ScaleXY/ESPS3Dongle/hardware/kicad/out/top.png

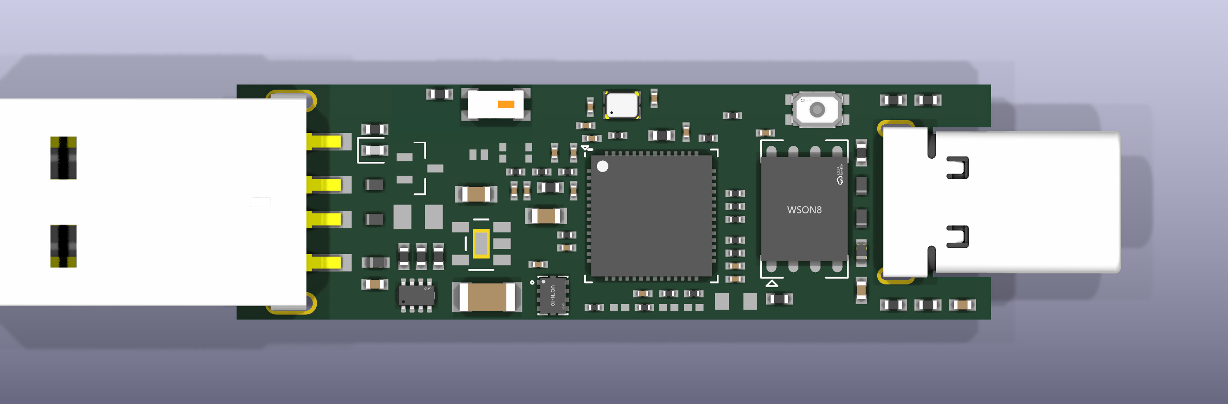
hardware/kicad/out/top.png
