ScaleXY/ESPS3Dongle/hardware/kicad/out/bottom.png

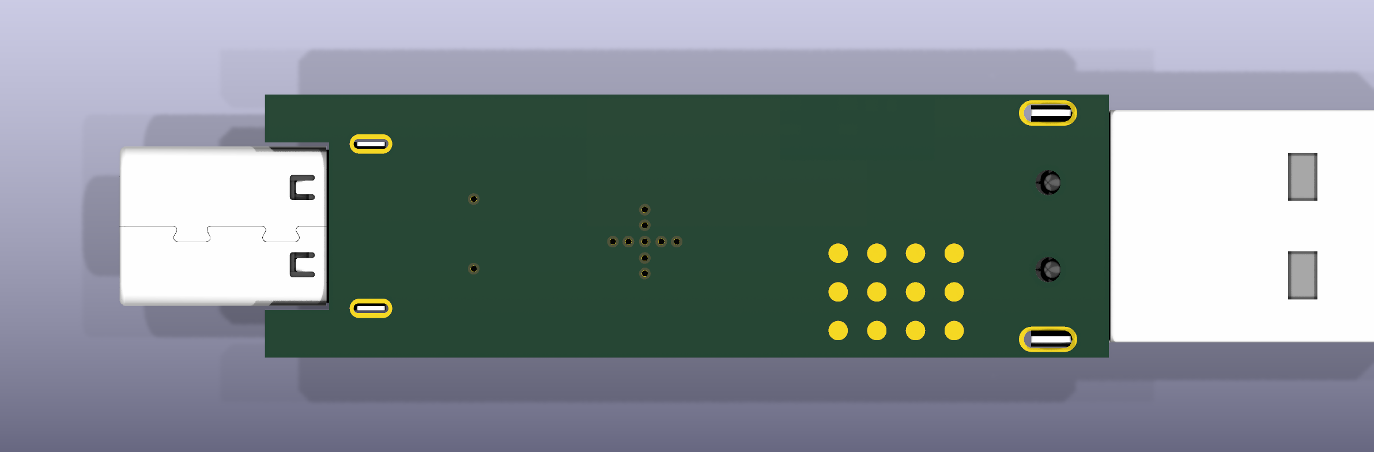
hardware/kicad/out/bottom.png
