ScaleXY/ESPS3Dongle/hardware/kicad/out/iso.png

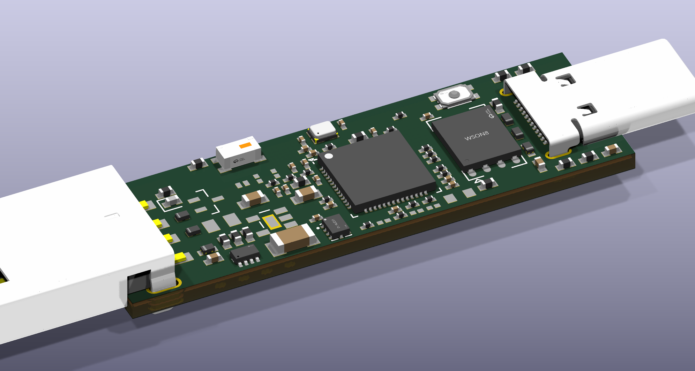
hardware/kicad/out/iso.png
