ScaleXY/ESPS3Dongle/hardware/kicad/out/schematic.pdf

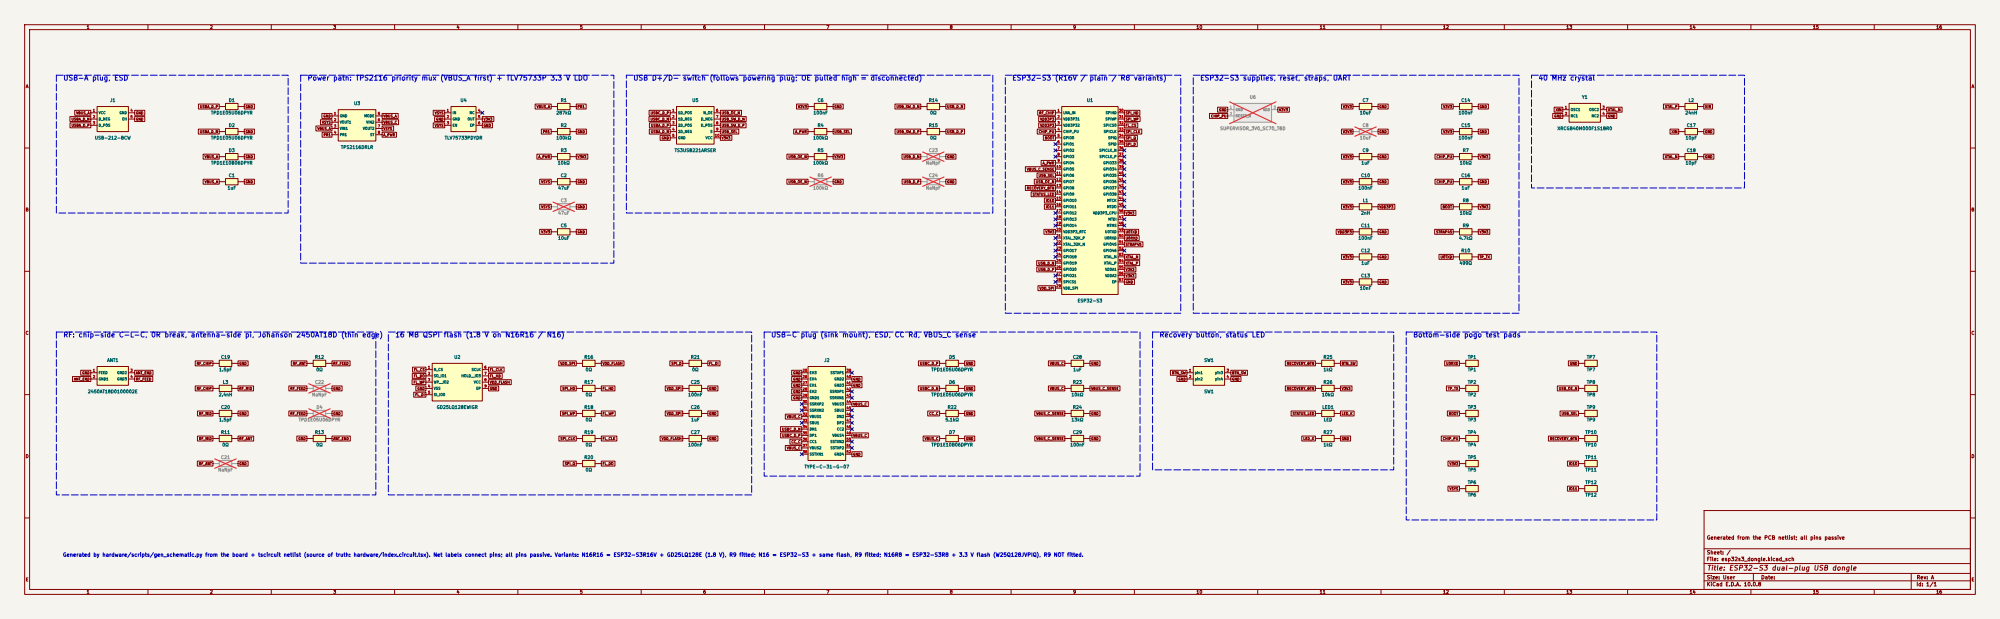
[picture p4: page 1]

USB D+/D- switch (follows powering plug; OE pulled high = disconnected)

ESP32-S3 supplies, reset, straps, UART

RF: chip-side C-L-C, 0R break, antenna-side pi, Johanson 2450AT18D (thin edge)

16 MB QSPI flash (1.8 V on N16R16 / N16)

Bottom-side pogo test pads

Generated from the PCB netlist; all pins passive

Generated by hardware/scripts/gen_schematic.py from the board + tscircuit netlist (source of truth: hardware/index.circuit.tsx). Net labels connect pins; all pins passive. Variants: N16R16 = ESP32-S3R16V + GD25LQ128E (1.8 V), R9 fitted; N16 = ESP32-S3 + same flash, R9 fitted; N16R8 = ESP32-S3R8 + 3.3 V flash (W25Q128JVPIQ), R9 NOT fitted.

Sheet: /
File: esp32s3_dongle.kicad_sch
Title: ESP32-S3 dual-plug USB dongle

Size: User | Rev: A
