ScaleXY/ESPS3Dongle/hardware/kicad/esp32s3_dongle.kicad_pcb

## KiCad design hardware/kicad/esp32s3_dongle.kicad_pcb (2026-11-11)

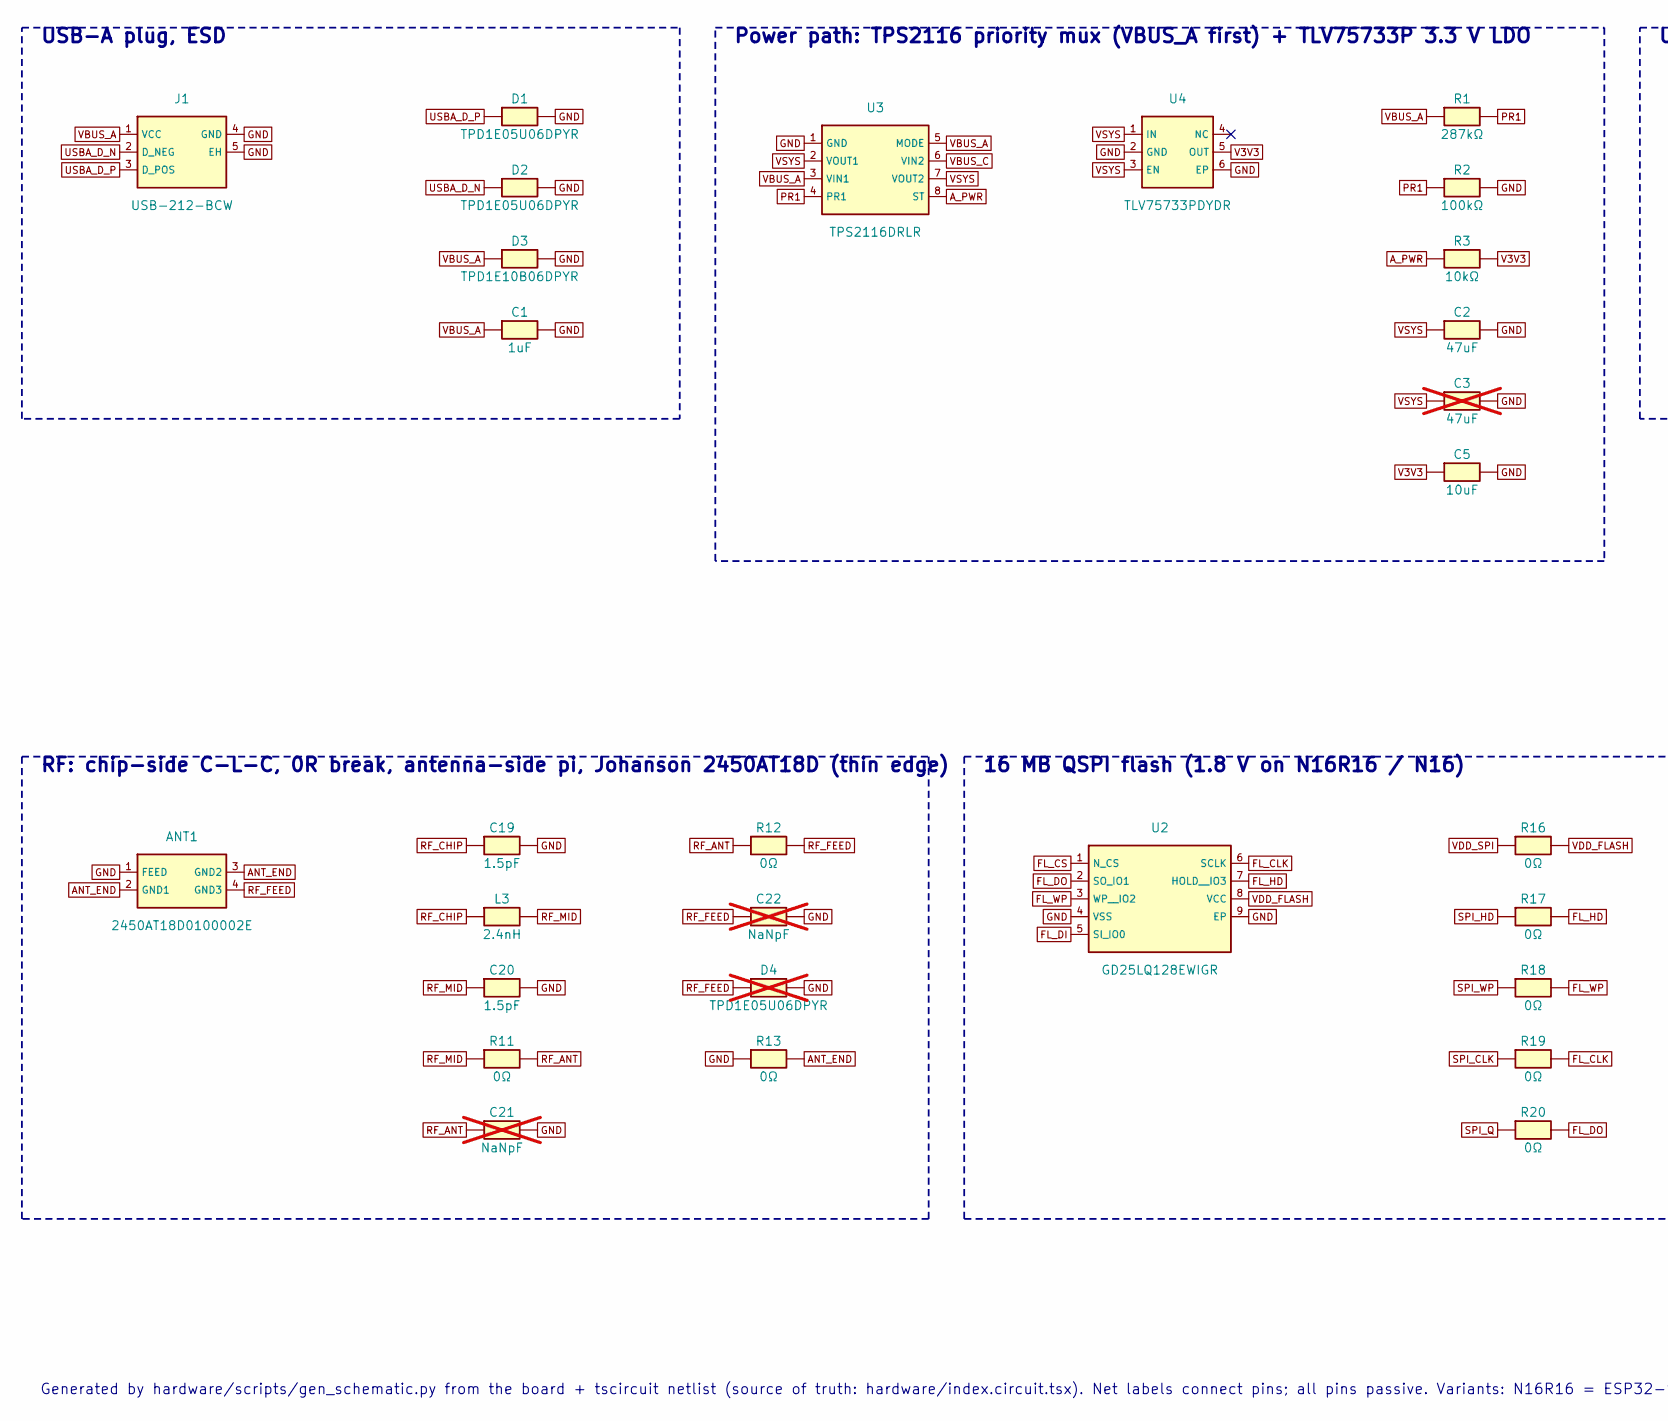
[picture p5: schematic esp32s3_dongle.kicad_sch, ESP32-S3 dual-plug USB dongle, part in row 1, column 1]

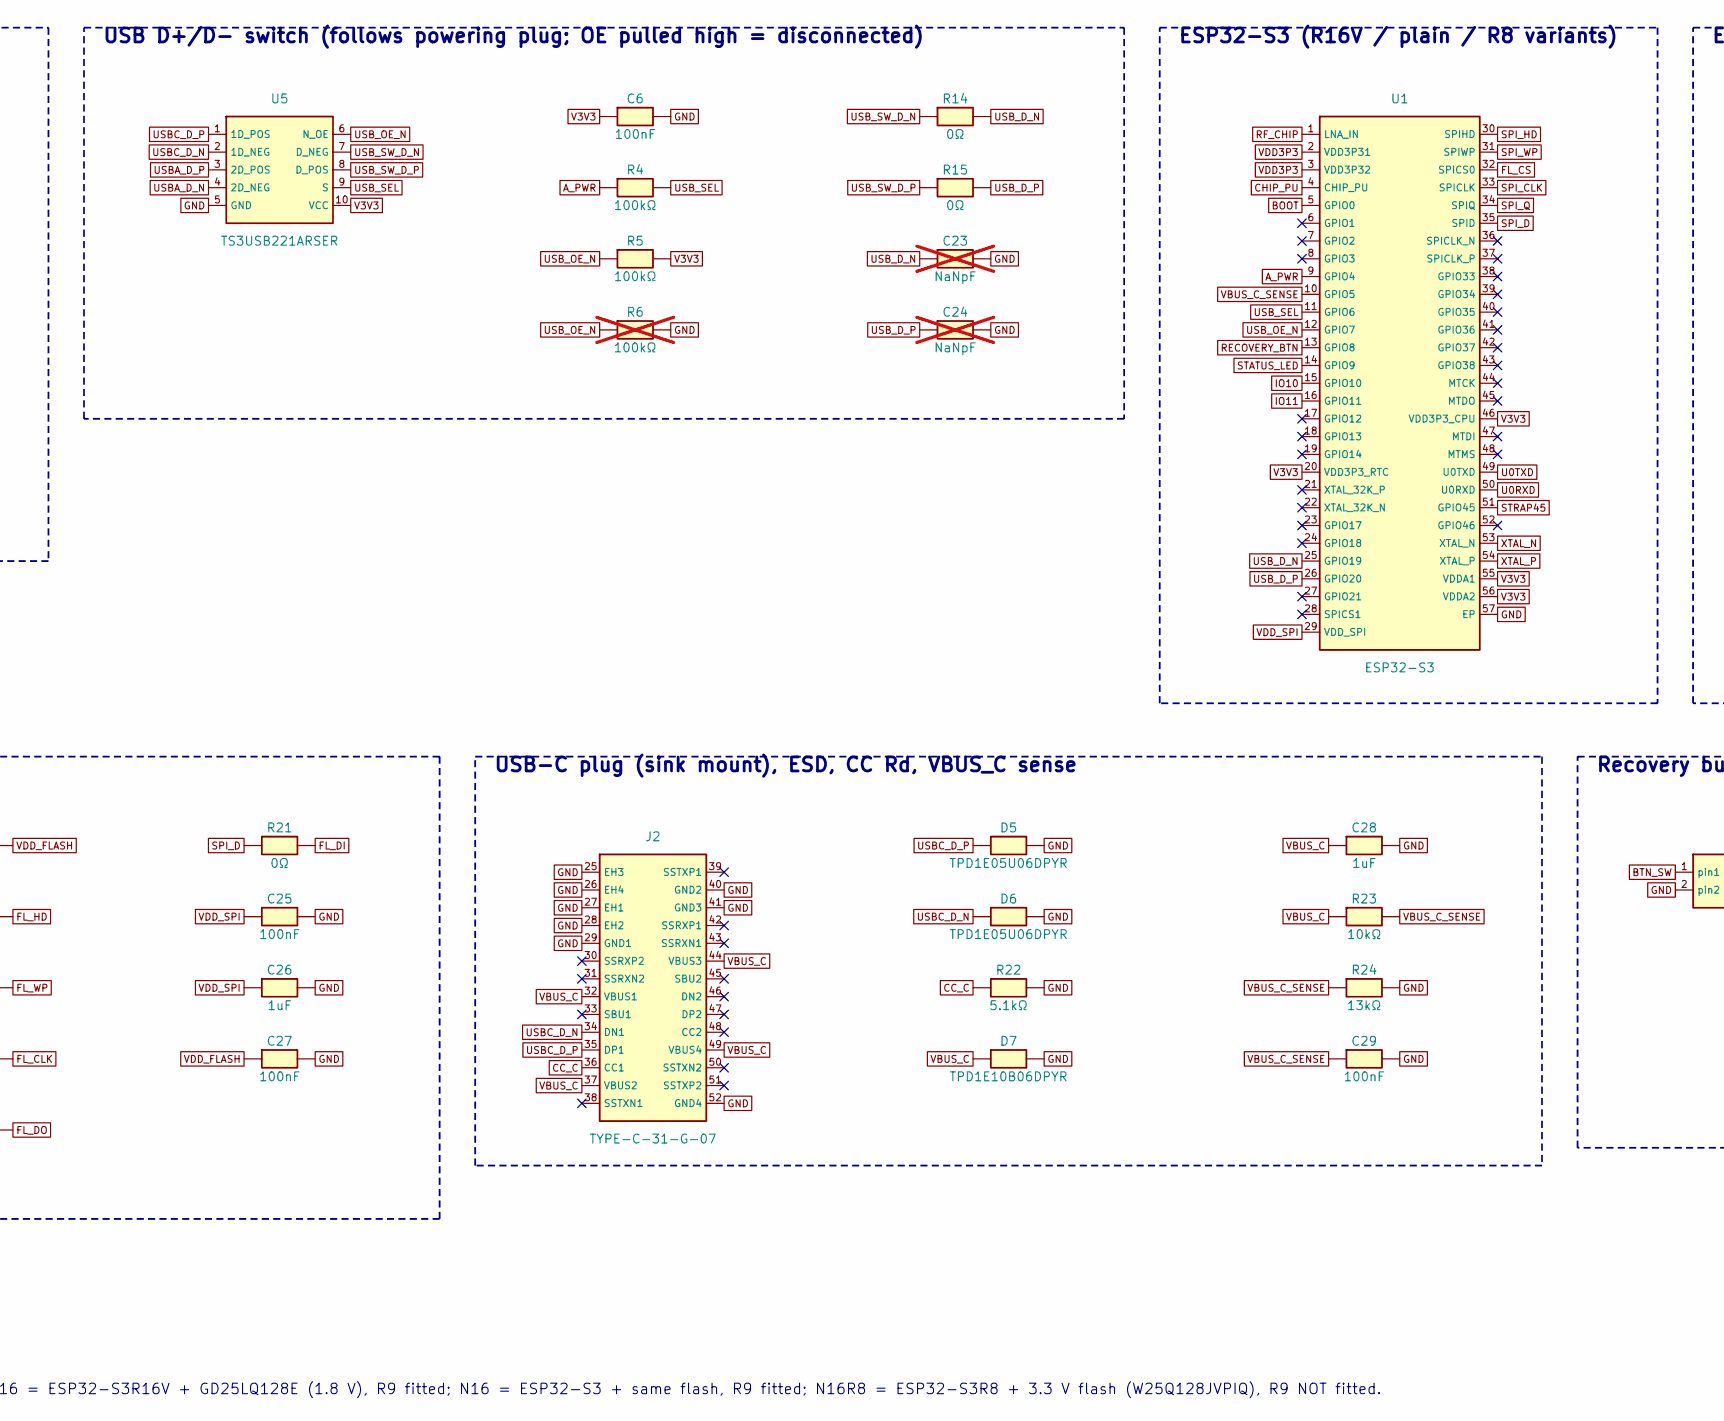
[picture p6: schematic esp32s3_dongle.kicad_sch, ESP32-S3 dual-plug USB dongle, part in row 1, column 2]

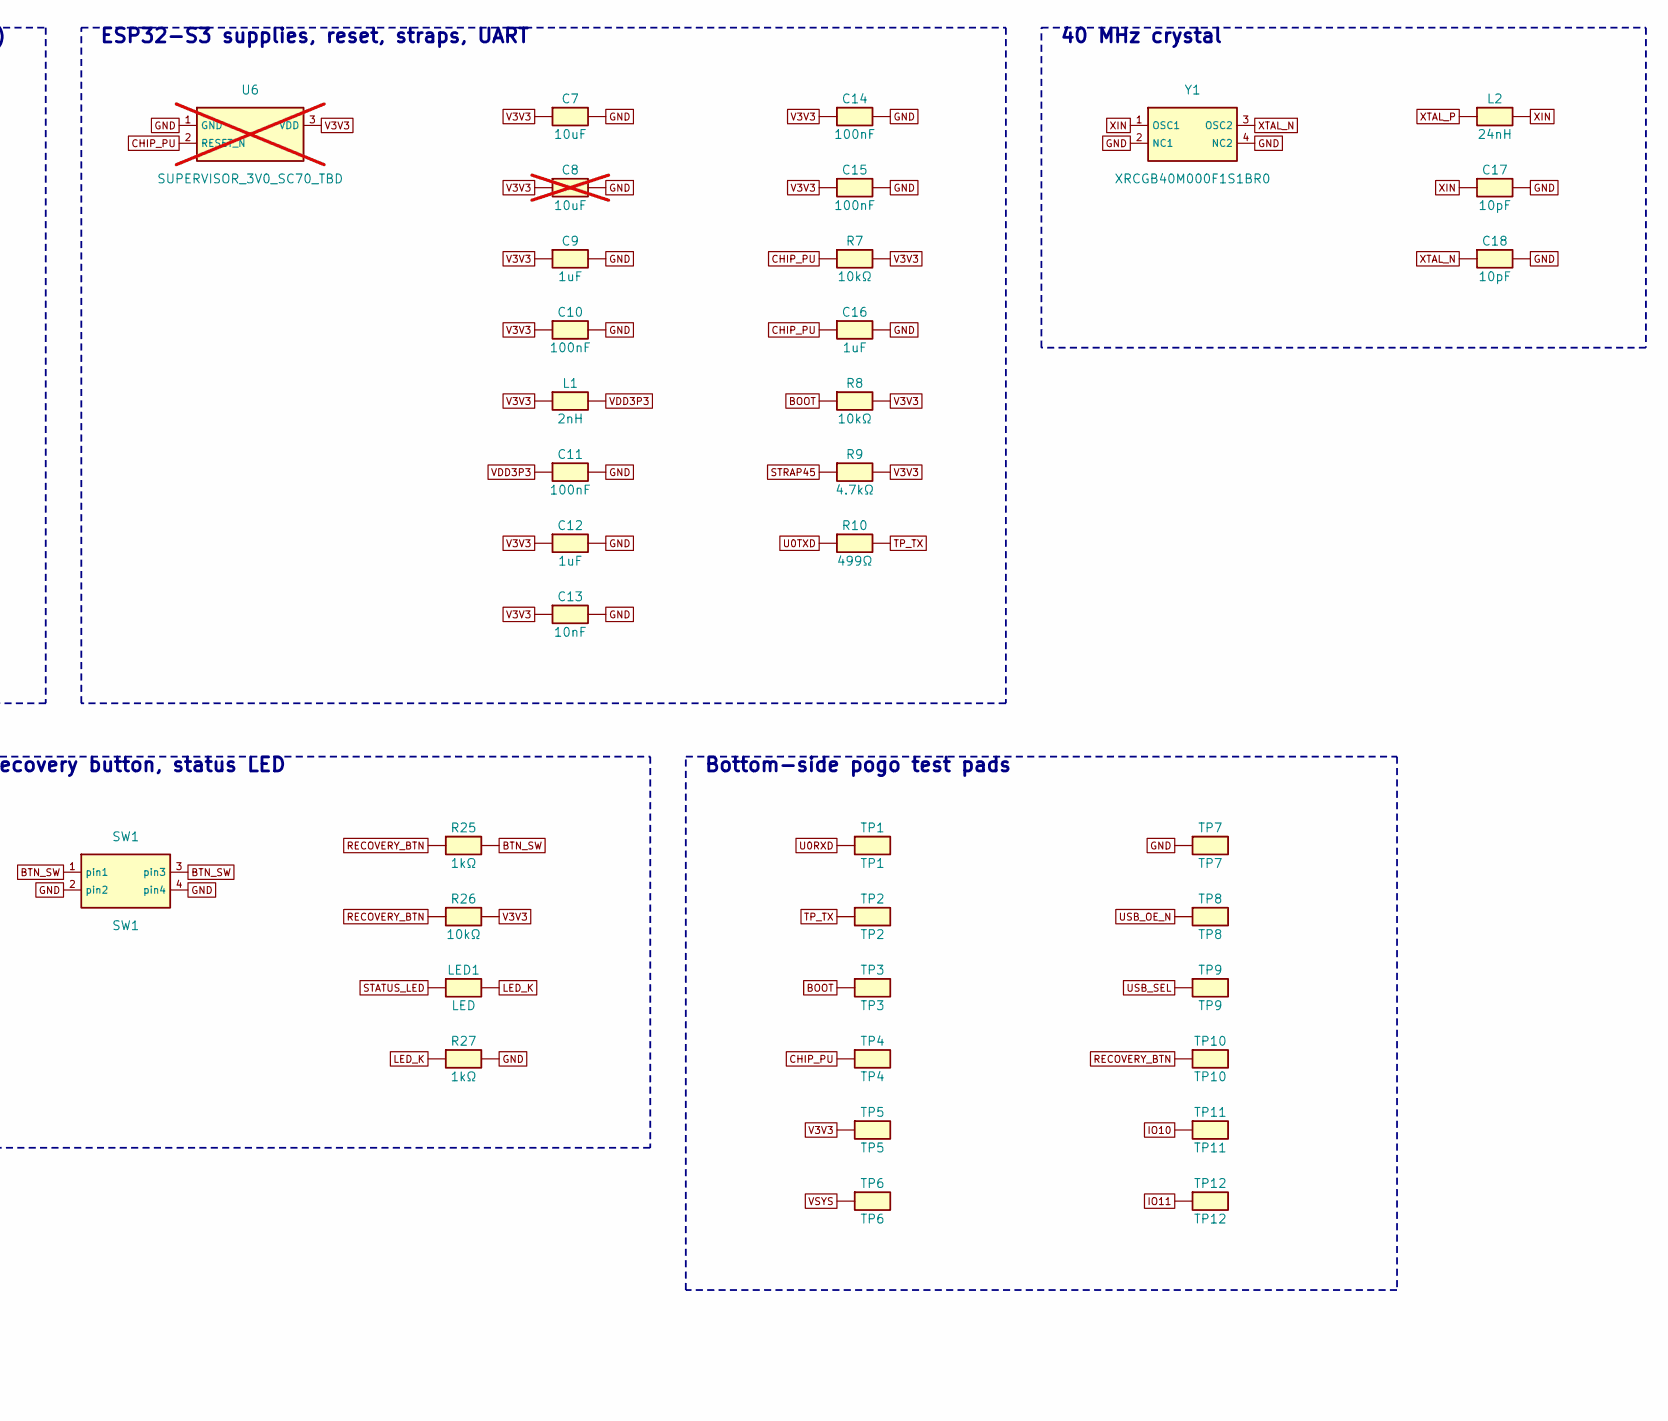
[picture p7: schematic esp32s3_dongle.kicad_sch, ESP32-S3 dual-plug USB dongle, part in row 1, column 3]

Parts:
ANT1: 2450AT18D0100002E; MPN 2450AT18D0100002E; LCSC C17410360
C1, C28: 1uF; capacitor_cap0402_nonpolarized
C2: 47uF; capacitor_cap1206_nonpolarized
C3: 47uF; capacitor; not fitted
C5, C7: 10uF; capacitor_cap0603_nonpolarized
C6, C10, C11, C14, C15, C25, C27: 100nF; capacitor_cap0201_nonpolarized
C8: 10uF; capacitor; not fitted
C9, C12, C16, C26: 1uF; capacitor_cap0201_nonpolarized
C13: 10nF; capacitor_cap0201_nonpolarized
C17, C18: 10pF; capacitor_cap0201_nonpolarized
C19, C20: 1.5pF; capacitor_cap0201_nonpolarized
C21, C22, C23, C24: NaNpF; capacitor; not fitted
C29: 100nF; capacitor_cap0402_nonpolarized
D1, D2, D5, D6: TPD1E05U06DPYR; MPN TPD1E05U06DPYR; LCSC C436349
D3, D7: TPD1E10B06DPYR; MPN TPD1E10B06DPYR; LCSC C48260
D4: TPD1E05U06DPYR; MPN TPD1E05U06DPYR; LCSC C436349; not fitted
J1: USB-212-BCW; MPN USB-212-BCW; LCSC C720521
J2: TYPE-C-31-G-07; MPN TYPE-C-31-G-07; LCSC C530607
L1: 2nH; inductor_0402
L2: 24nH; inductor_0201
L3: 2.4nH; inductor_0201
LED1: LED; led_diode0402_color_green
R1: 287kΩ; resistor_res0402
R2: 100kΩ; resistor_res0402
R3, R23, R26: 10kΩ; resistor_res0402
R4, R5: 100kΩ; resistor_res0201
R6: 100kΩ; resistor; not fitted
R7, R8: 10kΩ; resistor_res0201
R9: 4.7kΩ; resistor_res0402
R10: 499Ω; resistor_res0201
R11, R12, R14, R15, R17, R18, R19, R20, R21: 0Ω; resistor_res0201
R13, R16: 0Ω; resistor_res0402
R22: 5.1kΩ; resistor_res0402
R24: 13kΩ; resistor_res0402
R25, R27: 1kΩ; resistor_res0402
SW1: SW1; SKSVCAE010; MPN SKSVCAE010; LCSC C115364
TP1: TP1; test_point_smtpad_circle_d1
TP2: TP2; test_point_smtpad_circle_d1
TP3: TP3; test_point_smtpad_circle_d1
TP4: TP4; test_point_smtpad_circle_d1
TP5: TP5; test_point_smtpad_circle_d1
TP6: TP6; test_point_smtpad_circle_d1
TP7: TP7; test_point_smtpad_circle_d1
TP8: TP8; test_point_smtpad_circle_d1
TP9: TP9; test_point_smtpad_circle_d1
TP10: TP10; test_point_smtpad_circle_d1
TP11: TP11; test_point_smtpad_circle_d1
TP12: TP12; test_point_smtpad_circle_d1
U1: ESP32-S3; MPN ESP32-S3; LCSC C2913192
U2: GD25LQ128EWIGR; MPN GD25LQ128EWIGR; LCSC C2928889
U3: TPS2116DRLR; MPN TPS2116DRLR; LCSC C3235557
U4: TLV75733PDYDR; MPN TLV75733PDYDR; LCSC C22399950
U5: TS3USB221ARSER; MPN TS3USB221ARSER; LCSC C128396
U6: SUPERVISOR_3V0_SC70_TBD; MPN SUPERVISOR_3V0_SC70_TBD; not fitted
Y1: XRCGB40M000F1S1BR0; MPN XRCGB40M000F1S1BR0; LCSC C1870451

Connections:
ANT_END: ANT1.2 (GND1), ANT1.3 (GND2), R13.2
A_PWR: R3.1, R4.1, U1.9 (GPIO4), U3.8 (ST)
BOOT: R8.1, TP3.1, U1.5 (GPIO0)
BTN_SW: R25.2, SW1.1, SW1.3
CC_C: J2.36 (CC1), R22.1
CHIP_PU: C16.1, R7.1, TP4.1, U1.4 (CHIP_PU), U6.2 (RESET_N)
FL_CLK: R19.2, U2.6 (SCLK)
FL_CS: U1.32 (SPICS0), U2.1 (N_CS)
FL_DI: R21.2, U2.5 (SI_IO0)
FL_DO: R20.2, U2.2 (SO_IO1)
FL_HD: R17.2, U2.7 (HOLD__IO3)
FL_WP: R18.2, U2.3 (WP__IO2)
GND: ANT1.1 (FEED), C1.2, C2.2, C3.2, C5.2, C6.2, C7.2, C8.2, C9.2, C10.2, C11.2, C12.2, C13.2, C14.2, C15.2, C16.2, C17.2, C18.2, C19.2, C20.2, C21.2, C22.2, C23.2, C24.2, C25.2, C26.2, C27.2, C28.2, C29.2, D1.2 (GND), D2.2 (GND), D3.2, D4.2 (GND), D5.2 (GND), D6.2 (GND), D7.2, J1.4 (GND), J1.5 (EH), J2.25 (EH3), J2.26 (EH4), J2.27 (EH1), J2.28 (EH2), J2.29 (GND1), J2.40 (GND2), J2.41 (GND3), J2.52 (GND4), R2.2, R6.2, R13.1, R22.2, R24.2, R27.2, SW1.2, SW1.4, TP7.1, U1.57 (EP), U2.4 (VSS), U2.9 (EP), U3.1 (GND), U4.2 (GND), U4.6 (EP), U5.5 (GND), U6.1 (GND), Y1.2 (NC1), Y1.4 (NC2)
IO10: TP11.1, U1.15 (GPIO10)
IO11: TP12.1, U1.16 (GPIO11)
LED_K: LED1.2, R27.1
PR1: R1.2, R2.1, U3.4 (PR1)
RECOVERY_BTN: R25.1, R26.1, TP10.1, U1.13 (GPIO8)
RF_ANT: C21.1, R11.2, R12.1
RF_CHIP: C19.1, L3.1, U1.1 (LNA_IN)
RF_FEED: ANT1.4 (GND3), C22.1, D4.1 (I), R12.2
RF_MID: C20.1, L3.2, R11.1
SPI_CLK: R19.1, U1.33 (SPICLK)
SPI_D: R21.1, U1.35 (SPID)
SPI_HD: R17.1, U1.30 (SPIHD)
SPI_Q: R20.1, U1.34 (SPIQ)
SPI_WP: R18.1, U1.31 (SPIWP)
STATUS_LED: LED1.1, U1.14 (GPIO9)
STRAP45: R9.1, U1.51 (GPIO45)
TP_TX: R10.2, TP2.1
U0RXD: TP1.1, U1.50 (U0RXD)
U0TXD: R10.1, U1.49 (U0TXD)
USBA_D_N: D2.1 (I), J1.2 (D_NEG), U5.4 (2D_NEG)
USBA_D_P: D1.1 (I), J1.3 (D_POS), U5.3 (2D_POS)
USBC_D_N: D6.1 (I), J2.34 (DN1), U5.2 (1D_NEG)
USBC_D_P: D5.1 (I), J2.35 (DP1), U5.1 (1D_POS)
USB_D_N: C23.1, R14.2, U1.25 (GPIO19)
USB_D_P: C24.1, R15.2, U1.26 (GPIO20)
USB_OE_N: R5.1, R6.1, TP8.1, U1.12 (GPIO7), U5.6 (N_OE)
USB_SEL: R4.2, TP9.1, U1.11 (GPIO6), U5.9 (S)
USB_SW_D_N: R14.1, U5.7 (D_NEG)
USB_SW_D_P: R15.1, U5.8 (D_POS)
V3V3: C5.1, C6.1, C7.1, C8.1, C9.1, C10.1, C12.1, C13.1, C14.1, C15.1, L1.1, R3.2, R5.2, R7.2, R8.2, R9.2, R26.2, TP5.1, U1.20 (VDD3P3_RTC), U1.46 (VDD3P3_CPU), U1.55 (VDDA1), U1.56 (VDDA2), U4.5 (OUT), U5.10 (VCC), U6.3 (VDD)
VBUS_A: C1.1, D3.1, J1.1 (VCC), R1.1, U3.3 (VIN1), U3.5 (MODE)
VBUS_C: C28.1, D7.1, J2.32 (VBUS1), J2.37 (VBUS2), J2.44 (VBUS3), J2.49 (VBUS4), R23.1, U3.6 (VIN2)
VBUS_C_SENSE: C29.1, R23.2, R24.1, U1.10 (GPIO5)
VDD3P3: C11.1, L1.2, U1.2 (VDD3P31), U1.3 (VDD3P32)
VDD_FLASH: C27.1, R16.2, U2.8 (VCC)
VDD_SPI: C25.1, C26.1, R16.1, U1.29 (VDD_SPI)
VSYS: C2.1, C3.1, TP6.1, U3.2 (VOUT1), U3.7 (VOUT2), U4.1 (IN), U4.3 (EN)
XIN: C17.1, L2.2, Y1.1 (OSC1)
XTAL_N: C18.1, U1.53 (XTAL_N), Y1.3 (OSC2)
XTAL_P: L2.1, U1.54 (XTAL_P)

Notes on the sheet:
USB-A plug, ESD
Power path: TPS2116 priority mux (VBUS_A first) + TLV75733P 3.3 V LDO
USB D+/D- switch (follows powering plug; OE pulled high = disconnected)
ESP32-S3 (R16V / plain / R8 variants)
ESP32-S3 supplies, reset, straps, UART
40 MHz crystal
RF: chip-side C-L-C, 0R break, antenna-side pi, Johanson 2450AT18D (thin edge)
16 MB QSPI flash (1.8 V on N16R16 / N16)
USB-C plug (sink mount), ESD, CC Rd, VBUS_C sense
Recovery button, status LED
Bottom-side pogo test pads
Generated by hardware/scripts/gen_schematic.py from the board + tscircuit netlist (source of truth: hardware/index.circuit.tsx). Net labels connect pins; all pins passive. Variants: N16R16 = ESP32-S3R16V + GD25LQ128E (1.8 V), R9 fitted; N16 = ESP32-S3 + same flash, R9 fitted; N16R8 = ESP32-S3R8 + 3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

Board: 4 copper layers, 89 parts (12 on the bottom side), 53 nets, no tracks yet.
