ScaleXY/ESPS3Dongle/(commit log)

2026-11-11 Add detailed ESP32-S3 dongle design plans
    - Document hardware, firmware, USB modes, bring-up, and host programming tool
    - Add supporting research notes and lead verification
2026-11-11 Add tscircuit agent skill and PCB design references
    - Bundle CLI, syntax, workflow, and element documentation
    - Add routing guides, checklists, scripts, and circuit templates
    [esp32s3_dongle.kicad_pcb, esp32s3_dongle.kicad_sch]
